AfricanDaniel/metal-quadruped/dog_imu/README.md

# dog_imu

ROS 2 driver node for the LSM6DSO32 6-axis IMU, mounted on the Jetson and
read over I2C. Publishes `sensor_msgs/msg/Imu`.

Promoted from the `actuator/src/imu_reader.py` prototype (same
register-level driver logic, WHO_AM_I check included), but wired up as a
real publisher instead of printing to the console — this is what
`dog_deploy` subscribes to for the IMU half of a policy's observation, and
what `dog_gym`'s simulated `accelerometer`/`gyro` sensors are meant to
match the shape of.

```
dog_imu/
├── package.xml
├── setup.py / setup.cfg
├── resource/dog_imu
├── config/
│   └── imu_calibration.yaml   # generated by calibrate_imu, read by imu_node
├── data/imu_calibration/       # raw CSVs from each calibrate_imu run
└── dog_imu/
    ├── imu_node.py
    └── calibrate_imu_node.py
```

## Node: `imu_node`

On startup: opens the I2C bus, reads `WHO_AM_I` (logged for a sanity
check), configures the accelerometer (104 Hz, ±4g) and gyroscope (104 Hz,
500 dps), then publishes `sensor_msgs/Imu` on `imu/data_raw` on a timer.

- `angular_velocity` — rad/s (converted from the sensor's deg/s).
- `linear_acceleration` — m/s².
- `orientation` — left as identity with `orientation_covariance[0] = -1`,
  the `sensor_msgs/Imu` convention for "no orientation estimate available"
  (this sensor has no onboard sensor fusion — it's raw accel + gyro only).

Also publishes `imu/data` — the same readings rotated into a forward/left/up
(ROS REP-103) body frame, using `config/imu_calibration.yaml` — but only
once that file has actually been produced by `calibrate_imu` (see below).
Before that, only the raw `imu/data_raw` is published (a warning is logged
once at startup saying so).

**Why two topics**: the raw sensor's X/Y/Z axes are whatever direction the
physical board happens to be glued down in — there's no way to know which
one is "forward" without physically testing it (see `calibrate_imu`
below). `imu/data_raw` is always the sensor's own raw axes, unaffected by
calibration; `imu/data` is what `dog_deploy` and anything else that cares
about "forward/left/up" should actually subscribe to.

### Parameters

| Name | Type | Default | Description |
|---|---|---|---|
| `bus_id` | int | `7` | I2C bus number (Jetson Orin Nano: bus 7) |
| `i2c_addr` | int | `0x6A` | LSM6DSO32 I2C address |
| `frame_id` | string | `imu_link` | Frame ID stamped on published messages |
| `publish_rate_hz` | double | `1.0` | Publish rate (independent of the sensor's own ODR) |
| `calibration_path`  | string | `<share>/dog_imu/config/imu_calibration.yaml` | Where to look for the calibration file  |

## Node: `calibrate_imu`

Guided, physical calibration of the IMU's mounting orientation — walks
you through tilting the robot in 4 directions (nose down, nose up, left,
right, in that order) while `imu_node` is running, records the raw
readings, and figures out which raw axis is forward/left/up (and whether
each needs to be sign-flipped) purely from how the sensor actually
responded to being tilted. Writes:

- A timestamped raw-sample CSV to `data/imu_calibration/`.
- `config/imu_calibration.yaml`, picked up by `imu_node` on its next
  start (restart `imu_node` after calibrating).

**Re-run this any time the IMU gets unplugged, remounted, or otherwise
might have moved** — the calibration is a physical-mounting fact, not
something that can be assumed to stay valid. It's a ~30 second guided
procedure, not a one-time setup step.

```bash
# terminal 1
ros2 run dog_imu imu_node

# terminal 2 -- follow the on-screen prompts
ros2 run dog_imu calibrate_imu
```

To make a calibration persist across future `colcon build`s: a plain
(non-symlink) install only copies `config/imu_calibration.yaml` from the
*source* tree at build time, so copy the freshly-generated file over
`src/dog_imu/config/imu_calibration.yaml` once you're happy with it (and
commit it, same as `actuator/config/preset_pose.yaml`) — otherwise the
next rebuild reverts to whatever's currently checked in. The checked-in
file currently holds real calibration data from the robot (`calibrated:
true`, an identity axis mapping — no flips/rotation needed for this
mounting).

## Usage

```bash
colcon build --packages-select dog_imu
source install/setup.bash
ros2 run dog_imu imu_node
```

```bash
ros2 topic echo /imu/data_raw   # raw sensor axes, always available
ros2 topic echo /imu/data       # forward/left/up, only after calibrate_imu has run
```

Requires hardware (the LSM6DSO32 over I2C) — there's no simulated fallback
here, so this can only be run/verified on the Jetson, not the dev machine.

## Register map reference

Carried over from the original prototype:

- `0x0F` `WHO_AM_I` — read-only ID check.
- `0x10` `CTRL1_XL` — accelerometer ODR + full-scale. `0x58` = 104 Hz, ±4g.
- `0x11` `CTRL2_G` — gyroscope ODR + full-scale. `0x54` = 104 Hz, 500 dps.
- `0x22`-`0x27` — gyro X/Y/Z, 16-bit signed, low byte first.
- `0x28`-`0x2D` — accel X/Y/Z, 16-bit signed, low byte first.

Sensitivity for the settings above: gyro `0.0175 dps/LSB`, accel
`0.000122 g/LSB`.
