AfricanDaniel/metal-quadruped/dog_description/onshape_folders/robot_dog/assets/thigh_connecor_full.stl

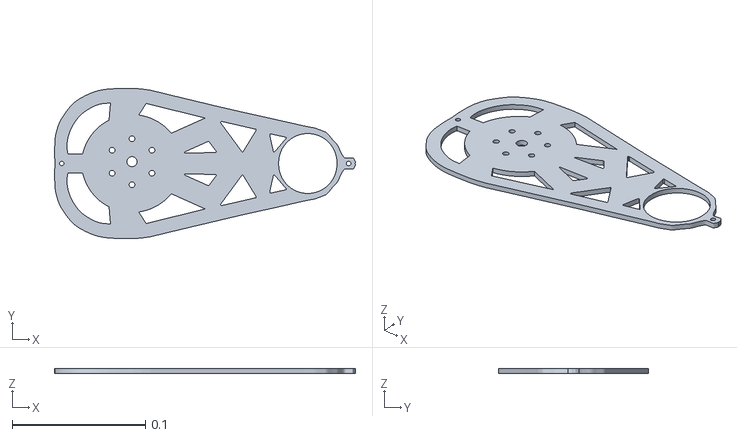
[picture p1: CAD file, 2026-07-23]
dog_description/onshape_folders/robot_dog/assets/thigh_connecor_full.stl
0.226 x 0.113 x 0.0035
