AfricanDaniel/metal-quadruped/dog_description/onshape_folders/robot_dog/assets/feet_connector.stl

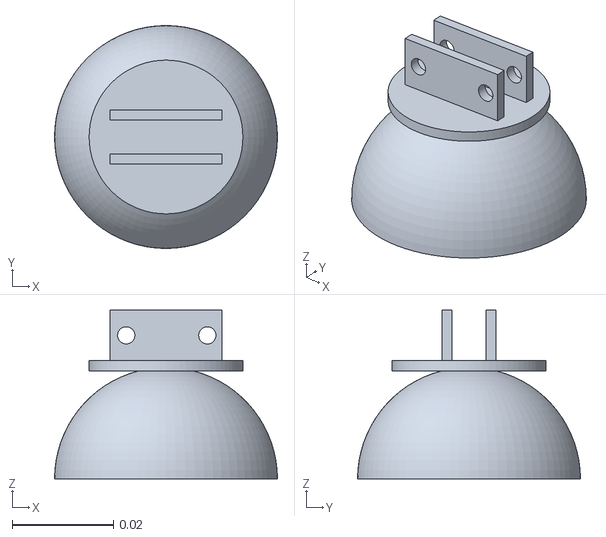
[picture p2: CAD file, 2026-07-23]
dog_description/onshape_folders/robot_dog/assets/feet_connector.stl
0.044 x 0.044 x 0.0333
