AfricanDaniel/metal-quadruped/dog_description/onshape_folders/urdf_dog/full_dog/meshes/motor_casing.stl

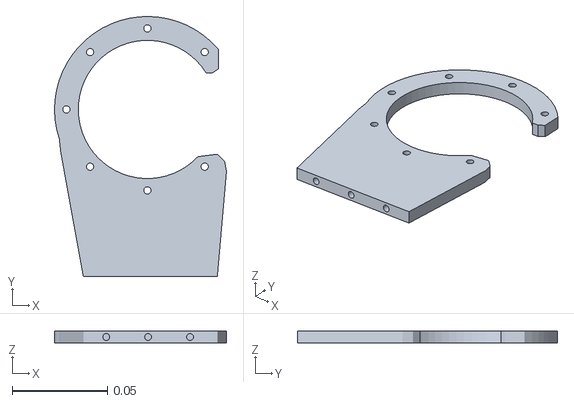
[picture p3: CAD file, 2026-07-23]
dog_description/onshape_folders/urdf_dog/full_dog/meshes/motor_casing.stl
0.0902 x 0.136 x 0.0065
