AfricanDaniel/metal-quadruped/dog_description/onshape_folders/robot_dog/assets/timing_belt_pulley_lower_shaft.stl

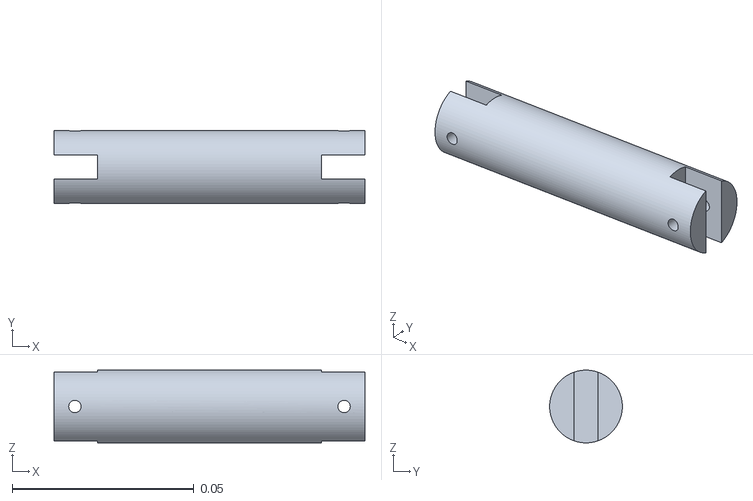
[picture p4: CAD file, 2026-07-23]
dog_description/onshape_folders/robot_dog/assets/timing_belt_pulley_lower_shaft.stl
0.0855 x 0.02 x 0.02
