AfricanDaniel/metal-quadruped/dog_description/onshape_folders/urdf_dog/full_dog/meshes/shoulder.stl

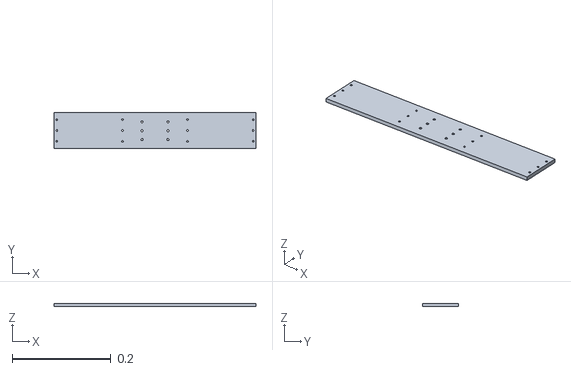
[picture p5: CAD file, 2026-07-23]
dog_description/onshape_folders/urdf_dog/full_dog/meshes/shoulder.stl
0.41 x 0.073 x 0.0065
