AfricanDaniel/metal-quadruped/dog_description/onshape_folders/robot_dog/assets/timing_belt_pulley_lower.stl

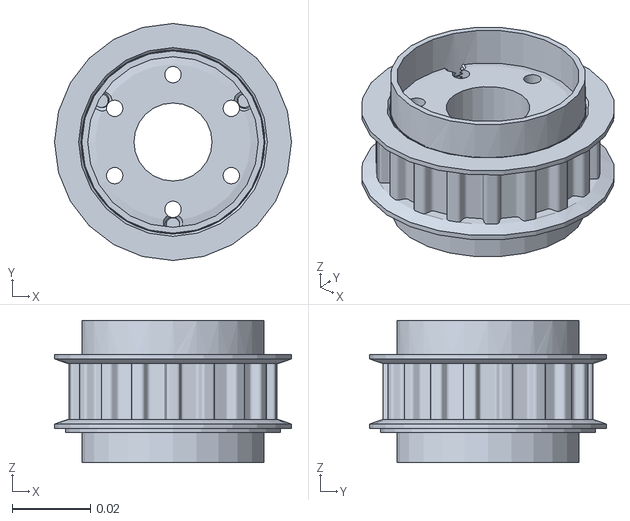
[picture p6: CAD file, 2026-07-23]
dog_description/onshape_folders/robot_dog/assets/timing_belt_pulley_lower.stl
0.0607 x 0.0607 x 0.0365
