AfricanDaniel/metal-quadruped/dog_description/onshape_folders/robot_dog/assets/motor_casing_spacers.stl

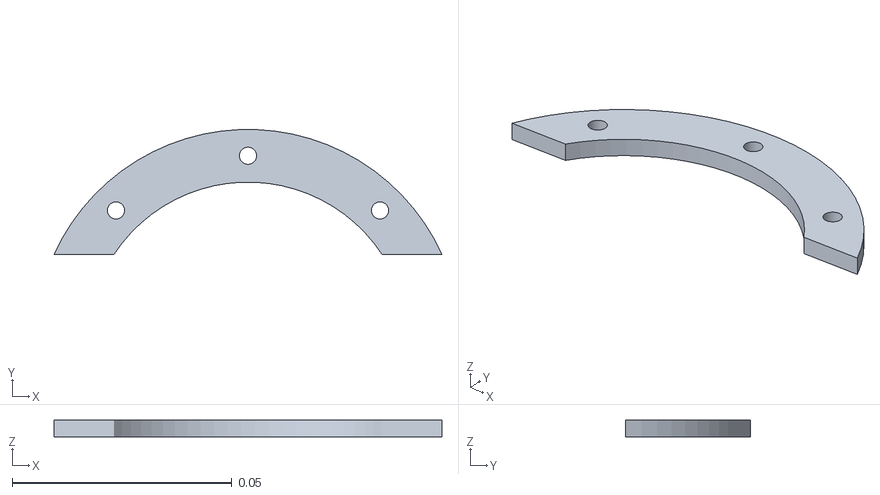
[picture p7: CAD file, 2026-07-23]
dog_description/onshape_folders/robot_dog/assets/motor_casing_spacers.stl
0.0883 x 0.0284 x 0.0038
