AfricanDaniel/metal-quadruped/dog_description/onshape_folders/robot_dog/assets/lower_shaft_connector_to_feet.stl

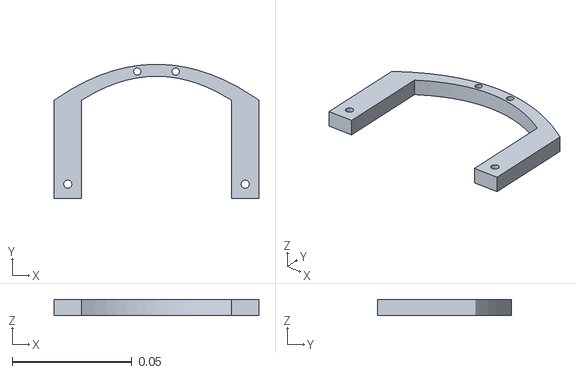
[picture p8: CAD file, 2026-07-23]
dog_description/onshape_folders/robot_dog/assets/lower_shaft_connector_to_feet.stl
0.0855 x 0.056 x 0.0067
