AfricanDaniel/metal-quadruped/dog_description/onshape_folders/urdf_dog/full_dog/meshes/battery.stl

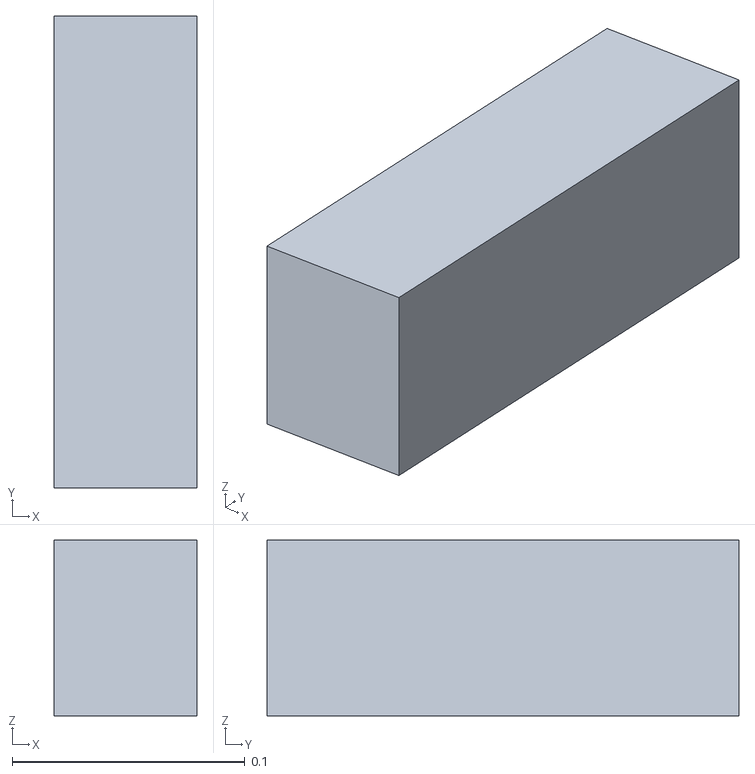
[picture p9: CAD file, 2026-07-23]
dog_description/onshape_folders/urdf_dog/full_dog/meshes/battery.stl
0.0615 x 0.203 x 0.0755
