AfricanDaniel/metal-quadruped/dog_description/onshape_folders/robot_dog/assets/motor.stl

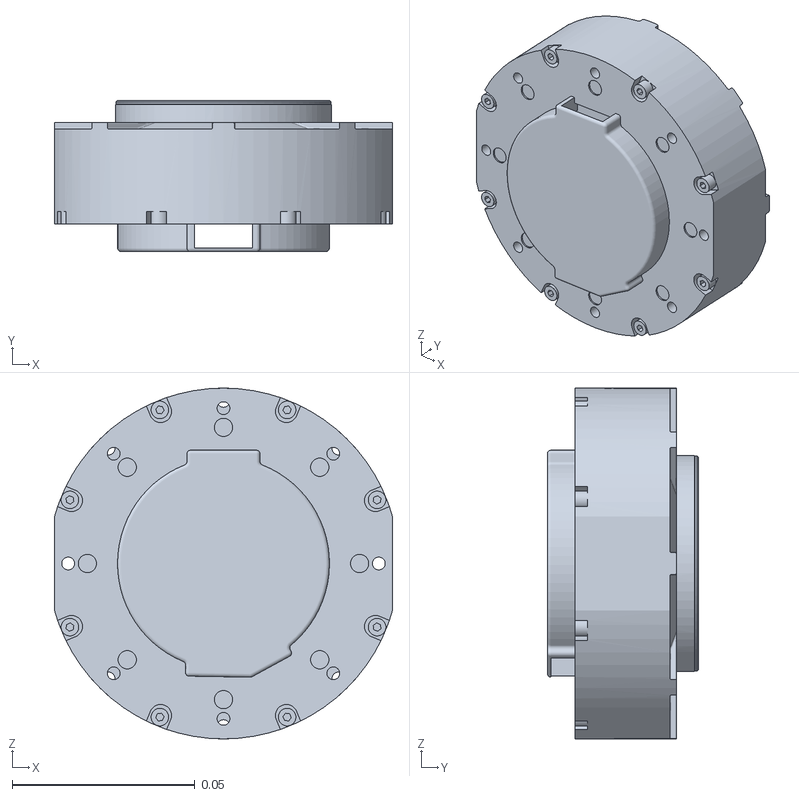
[picture p10: CAD file, 2026-07-23]
dog_description/onshape_folders/robot_dog/assets/motor.stl
0.0925 x 0.0414 x 0.096
