AfricanDaniel/metal-quadruped/dog_description/onshape_folders/urdf_dog/full_dog/meshes/ball_for_feet.stl

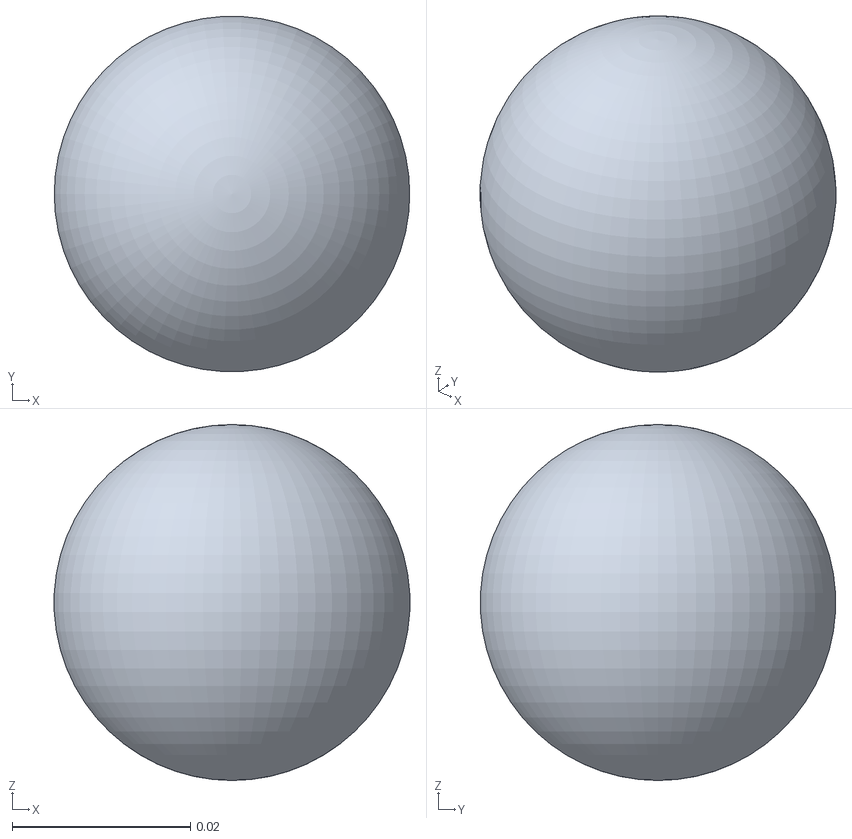
[picture p11: CAD file, 2026-07-23]
dog_description/onshape_folders/urdf_dog/full_dog/meshes/ball_for_feet.stl
0.0399 x 0.0399 x 0.04
