AfricanDaniel/metal-quadruped/dog_description/onshape_folders/urdf_dog/full_dog/meshes/timing_belt_pulley_upper.stl

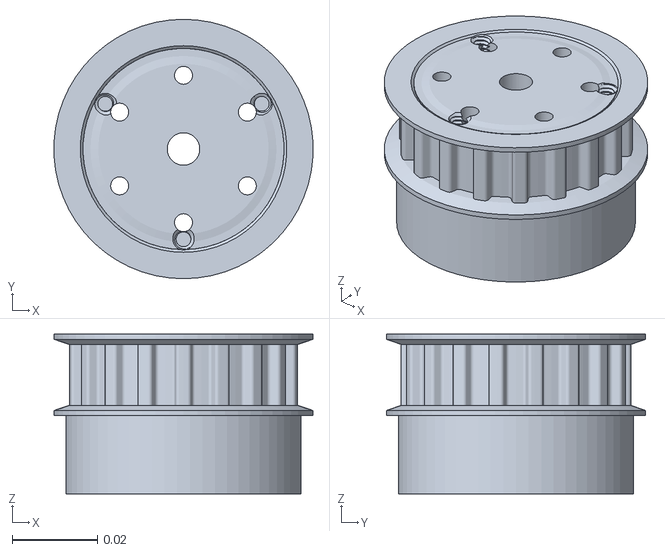
[picture p12: CAD file, 2026-07-23]
dog_description/onshape_folders/urdf_dog/full_dog/meshes/timing_belt_pulley_upper.stl
0.0606 x 0.0607 x 0.0373
