AfricanDaniel/metal-quadruped/dog_description/onshape_folders/robot_dog/assets/spacer_between_thigh_connector.stl

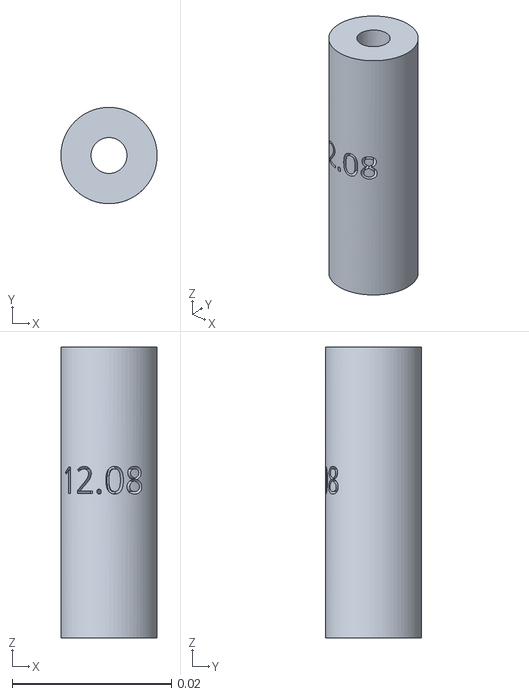
[picture p13: CAD file, 2026-07-23]
dog_description/onshape_folders/robot_dog/assets/spacer_between_thigh_connector.stl
0.0121 x 0.0121 x 0.0365
