AfricanDaniel/metal-quadruped/dog_description/onshape_folders/urdf_dog/full_dog/meshes/torso.stl

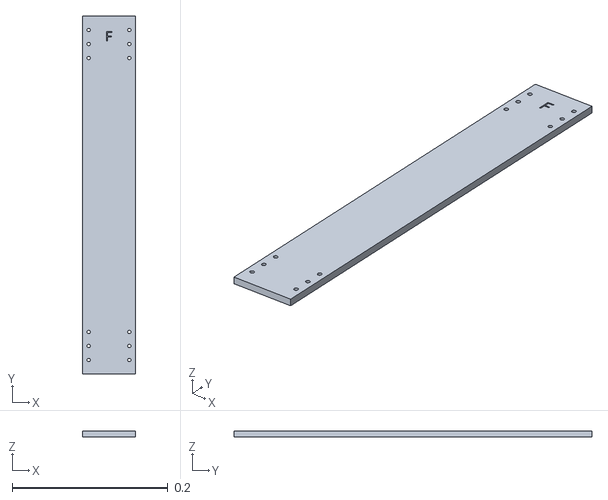
[picture p14: CAD file, 2026-07-23]
dog_description/onshape_folders/urdf_dog/full_dog/meshes/torso.stl
0.0675 x 0.46 x 0.0072
