AfricanDaniel/metal-quadruped/dog_description/onshape_folders/urdf_dog/full_dog/meshes/thigh_connector_hollow.stl

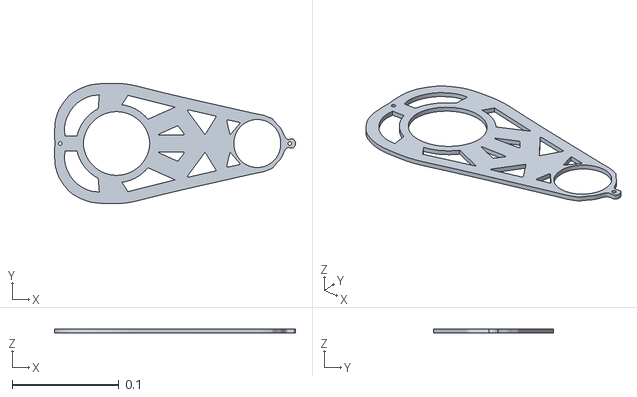
[picture p15: CAD file, 2026-07-23]
dog_description/onshape_folders/urdf_dog/full_dog/meshes/thigh_connector_hollow.stl
0.226 x 0.113 x 0.0035
