AfricanDaniel/metal-quadruped/dog_description/onshape_folders/urdf_dog/full_dog/meshes/Part_B_1__Body1.stl

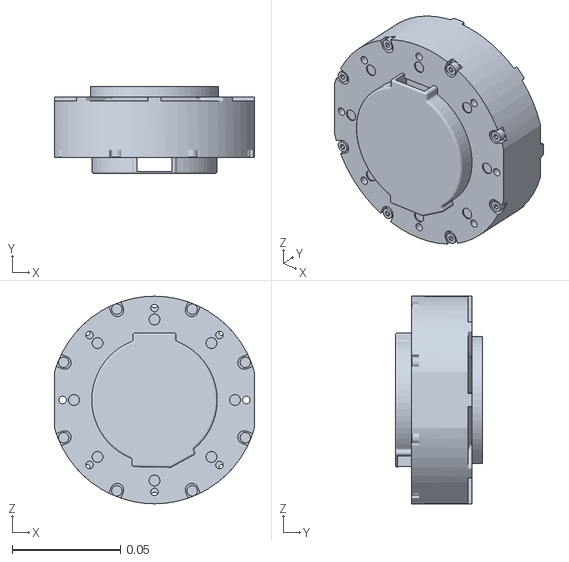
[picture p16: CAD file, 2026-07-23]
dog_description/onshape_folders/urdf_dog/full_dog/meshes/Part_B_1__Body1.stl
0.0925 x 0.0403 x 0.096
