AfricanDaniel/metal-quadruped/dog_description/onshape_folders/robot_dog/assets/imu.stl

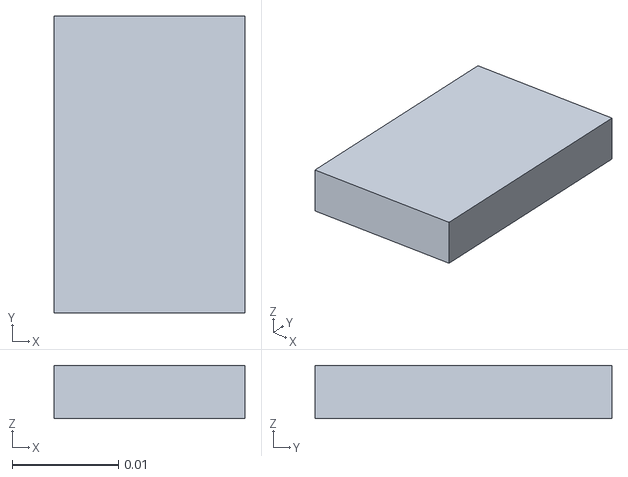
[picture p17: CAD file, 2026-07-23]
dog_description/onshape_folders/robot_dog/assets/imu.stl
0.018 x 0.028 x 0.005
