AfricanDaniel/metal-quadruped/dog_description/onshape_folders/urdf_dog/full_dog/meshes/Part_A_1__Body1.stl

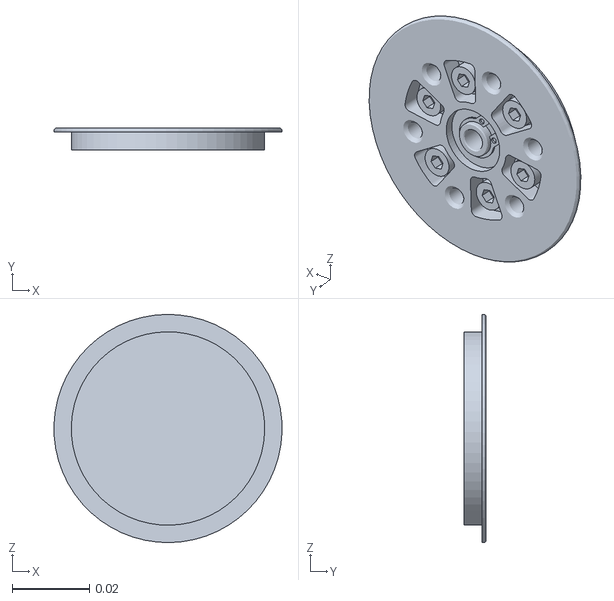
[picture p18: CAD file, 2026-07-23]
dog_description/onshape_folders/urdf_dog/full_dog/meshes/Part_A_1__Body1.stl
0.059 x 0.0057 x 0.059
