AfricanDaniel/metal-quadruped/(list of files, cad)

Other CAD files:
dog_description/onshape_folders/urdf_dog/full_dog/meshes/thigh_connecor_full.stl
dog_description/onshape_folders/urdf_dog/full_dog/meshes/timing_belt_pulley_lower.stl
dog_description/onshape_folders/urdf_dog/full_dog/meshes/timing_belt_pulley_lower_shaft.stl
dog_description/onshape_folders/urdf_dog/full_dog/meshes/lower_shaft_connector_to_feet.stl
dog_description/onshape_folders/robot_dog/assets/shoulder.stl
dog_description/onshape_folders/robot_dog/assets/motor_casing.stl
dog_description/onshape_folders/robot_dog/assets/ball_for_feet.stl
dog_description/onshape_folders/urdf_dog/full_dog/meshes/feet_connector.stl
dog_description/onshape_folders/robot_dog/assets/torso.stl
dog_description/onshape_folders/robot_dog/assets/thigh_connector_hollow.stl
dog_description/onshape_folders/urdf_dog/full_dog/meshes/spacer_between_thigh_connector.stl
dog_description/onshape_folders/robot_dog/assets/timing_belt_pulley_upper.stl
dog_description/onshape_folders/robot_dog/assets/battery.stl
dog_description/onshape_folders/urdf_dog/full_dog/meshes/IMU.stl
dog_description/onshape_folders/urdf_dog/full_dog/meshes/motor_casing_spacers.stl
