AfricanDaniel/metal-quadruped/dog_description/onshape_folders/urdf_dog/full_dog/urdf/full_dog.urdf

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
<robot name="full_dog">
    <link name="ball_for_feet">
        <inertial>
            <mass value="0.0368614" />
            <origin xyz="4.59243e-19 0 -3.46945e-18" rpy="0 -0 0" />
            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
        </inertial>
        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
    </link>
    <link name="ball_for_feet_1">
        <inertial>
            <mass value="0.0368614" />
            <origin xyz="4.59243e-19 0 -3.46945e-18" rpy="0 -0 0" />
            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
        </inertial>
        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
    </link>
    <link name="ball_for_feet_2">
        <inertial>
            <mass value="0.0368614" />
            <origin xyz="4.59243e-19 0 -3.46945e-18" rpy="0 -0 0" />
            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
        </inertial>
        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
    </link>
    <link name="ball_for_feet_3">
        <inertial>
            <mass value="0.0368614" />
            <origin xyz="4.59243e-19 0 -3.46945e-18" rpy="0 -0 0" />
            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
        </inertial>
        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
    </link>
    <link name="battery">
        <inertial>
            <mass value="1.17822" />
            <origin xyz="-0.03075 -2.47868e-17 -6.93889e-18" rpy="0 -0 0" />
            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
        </inertial>
        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
    </link>
    <link name="feet_connector">
        <inertial>
            <mass value="0.00970941" />
            <origin xyz="-0.0081562 -0.00335 -0.0138107" rpy="0 -0 0" />
            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
        </inertial>
        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
    </link>
    <link name="feet_connector_1">
        <inertial>
            <mass value="0.00970941" />
            <origin xyz="-0.0081562 -0.00335 -0.0138107" rpy="0 -0 0" />
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
        </inertial>
        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
    </link>
    <link name="timing_belt_pulley_lower_shaft">
        <inertial>
            <mass value="0.0633572" />
            <origin xyz="3.56914e-18 -1.42421e-13 9.15845e-14" rpy="0 -0 0" />
            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
        </inertial>
        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
    </link>
    <link name="timing_belt_pulley_lower_shaft_1">
        <inertial>
            <mass value="0.0633572" />
            <origin xyz="3.56914e-18 -1.42421e-13 9.15845e-14" rpy="0 -0 0" />
            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
        </inertial>
        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
    </link>
    <link name="timing_belt_pulley_lower_shaft_2">
        <inertial>
            <mass value="0.0633572" />
            <origin xyz="3.56914e-18 -1.42421e-13 9.15845e-14" rpy="0 -0 0" />
            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
        </inertial>
        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
    </link>
    <link name="timing_belt_pulley_lower_shaft_3">
        <inertial>
            <mass value="0.0633572" />
            <origin xyz="3.56914e-18 -1.42421e-13 9.15845e-14" rpy="0 -0 0" />
            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
        </inertial>
        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
    </link>
    <link name="timing_belt_pulley_upper">
        <inertial>
            <mass value="0.0998201" />
            <origin xyz="7.78619e-09 4.72925e-09 0.0181907" rpy="0 -0 0" />
            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
        </inertial>
        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
    </link>
    <link name="timing_belt_pulley_upper_1">
        <inertial>
            <mass value="0.0998201" />
            <origin xyz="7.78619e-09 4.72925e-09 0.0181907" rpy="0 -0 0" />
            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
        </inertial>
        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
    </link>
    <link name="timing_belt_pulley_upper_2">
        <inertial>
            <mass value="0.0998201" />
            <origin xyz="7.78619e-09 4.72925e-09 0.0181907" rpy="0 -0 0" />
            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
        </inertial>
        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
    </link>
    <link name="timing_belt_pulley_upper_3">
        <inertial>
            <mass value="0.0998201" />
            <origin xyz="7.78619e-09 4.72925e-09 0.0181907" rpy="0 -0 0" />
            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
        </inertial>
        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
    </link>
    <link name="torso">
        <inertial>
            <mass value="0.599638" />
            <origin xyz="4.79264e-07 -9.0235e-05 0.00359908" rpy="0 -0 0" />
            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
        </inertial>
        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
    </link>
    <joint name="_bll__fastened_feet_connector_and_rubber_ball" type="fixed">
        <origin xyz="-0.00815475 -0.00335 -0.028333" rpy="2.13916e-61 1.57772e-30 2.71171e-31" />
        <axis xyz="0 0 1" />
        <parent link="feet_connector_3" />
        <child link="ball_for_feet" />
    </joint>
    <joint name="_bll__fastened_horseshoe_and_feet_conector" type="fixed">
        <origin xyz="0.045 0.0469611 -1.38778e-17" rpy="1.5708 -1.52842e-30 -3.45127e-31" />
        <axis xyz="0 -1 0" />
        <parent link="lower_shaft_connector_to_feet_1" />
        <child link="feet_connector_3" />
    </joint>
    <joint name="_bll__fastened_motor_7_and_lower_spacer" type="fixed">
        <origin xyz="0.085 0 2.77556e-17" rpy="0 -1.5708 -1.5708" />
        <axis xyz="0 0 1" />
        <parent link="part_a_1__body1_4" />
        <child link="motor_casing_spacers_14" />
    </joint>
    <joint name="_bll__fastened_motor_7_and_timing_belt_upper" type="fixed">
        <origin xyz="0.0425 0.0339 8.32667e-17" rpy="-1.5708 -5.9559e-29 6.07873e-15" />
        <axis xyz="0 0 -1" />
        <parent link="part_a_1__body1_4" />
        <child link="timing_belt_pulley_upper_2" />
    </joint>
    <joint name="_bll__fastened_motor_7_and_upper_spacer" type="fixed">
        <origin xyz="-2.77556e-17 2.77556e-17 0.0038" rpy="1.5708 -0 -1.5708" />
        <axis xyz="-0 -1 -0" />
        <parent link="motor_casing_spacers_7" />
        <child link="part_a_1__body1_4" />
    </joint>
    <joint name="_bll__fastened_motor_7_casing_and_spacers" type="fixed">
        <origin xyz="-0.0223731 0.0451405 0.00325" rpy="1.46406e-61 1.47911e-31 -3.14159" />
        <axis xyz="0 0 -1" />
        <parent link="motor_casing_4" />
        <child link="motor_casing_spacers_7" />
    </joint>
    <joint name="_bll__fastened_motor_8_and_lower_spacer" type="fixed">
        <origin xyz="-0.085 -2.77556e-17 2.77556e-17" rpy="0 1.5708 1.5708" />
        <axis xyz="0 0 1" />
        <parent link="part_a_1__body1_1" />
        <child link="motor_casing_spacers_5" />
    </joint>
    <joint name="_bll__fastened_motor_8_and_upper_spacer" type="fixed">
        <origin xyz="2.77556e-17 2.77556e-17 0.0038" rpy="1.5708 -0 1.5708" />
        <axis xyz="-0 -1 -0" />
        <parent link="motor_casing_spacers_8" />
        <child link="part_a_1__body1_1" />
    </joint>
    <joint name="_bll__fastened_motor_8_casing_and_spacers" type="fixed">
        <origin xyz="-0.0223731 0.0451405 -0.00325" rpy="3.14159 -7.1325e-43 1.17327e-28" />
        <axis xyz="0 0 -1" />
        <parent link="motor_casing_3" />
        <child link="motor_casing_spacers_8" />
    </joint>
    <joint name="_bll__fastened_screw_spacer_and_full_thigh" type="fixed">
        <origin xyz="-0.0501423 -0.0163467 0.0035" rpy="3.14159 2.78234e-30 -1.28134" />
        <axis xyz="0 0 1" />
        <parent link="thigh_connecor_full_2" />
        <child link="spacer_between_thigh_connector_2" />
    </joint>
    <joint name="_bll__fastened_screw_spacer_and_hollow_thigh" type="fixed">
        <origin xyz="4.85723e-17 0 -0.0365" rpy="-3.14159 -1.30162e-29 -1.5708" />
        <axis xyz="-0 -0 -1" />
        <parent link="spacer_between_thigh_connector_2" />
        <child link="thigh_connector_hollow_3" />
    </joint>
    <joint name="_bll__fastened_shaft_and_horseshoe" type="fixed">
        <origin xyz="-0.037 -0.00335 0" rpy="1.5708 -2.36658e-30 -5.2262e-30" />
        <axis xyz="0 0 1" />
        <parent link="timing_belt_pulley_lower_shaft_2" />
        <child link="lower_shaft_connector_to_feet_1" />
    </joint>
    <joint name="_bll__fastened_shoulder_and_motor_7_casing" type="fixed">
        <origin xyz="-0.0922 0.0045 -0.0065" rpy="-1.5708 -0 1.5708" />
        <axis xyz="0 -1 0" />
        <parent link="shoulder" />
        <child link="motor_casing_4" />
    </joint>
    <joint name="_bll__fastened_shoulder_and_motor_8_casing" type="fixed">
        <origin xyz="-0.22545 0.0045 -0.0065" rpy="-1.5708 -0 1.5708" />
        <axis xyz="0 -1 0" />
        <parent link="shoulder" />
        <child link="motor_casing_3" />
    </joint>
    <joint name="_bll__fastened_timing_belt_shaft_and_lower_pulley" type="fixed">
        <origin xyz="2.31482e-14 7.96585e-15 0.01775" rpy="0 -1.5708 3.47241" />
        <axis xyz="-1 -0 -0" />
        <parent link="timing_belt_pulley_lower_3" />
        <child link="timing_belt_pulley_lower_shaft_2" />
    </joint>
    <joint name="_bll__revolute_motor_8_and_thigh" type="continuous">
        <origin xyz="-0.0425 0.0337 8.32667e-17" rpy="0 -1.5708 -1.5708" />
        <axis xyz="0 0 -1" />
        <parent link="part_a_1__body1_1" />
        <child link="thigh_connecor_full_2" />
    </joint>
    <joint name="_bll__revolute_thigh_and_lower_pulley" type="continuous">
        <origin xyz="0.184559 0.000619719 0" rpy="-3.14159 9.04594e-21 -1.5708" />
        <axis xyz="0 0 -1" />
        <parent link="thigh_connector_hollow_3" />
        <child link="timing_belt_pulley_lower_3" />
    </joint>
    <joint name="_brl__fastened_feet_connector_and_rubber_ball" type="fixed">
        <origin xyz="-0.00815475 -0.00335 -0.028333" rpy="0 -0 7.39557e-31" />
        <axis xyz="0 0 1" />
        <parent link="feet_connector_2" />
        <child link="ball_for_feet_1" />
    </joint>
    <joint name="_brl__fastened_horseshoe_and_feet_conector" type="fixed">
        <origin xyz="0.045 0.0469611 -1.38778e-17" rpy="1.5708 -7.39557e-31 1.97215e-31" />
        <axis xyz="0 -1 0" />
        <parent link="lower_shaft_connector_to_feet" />
        <child link="feet_connector_2" />
    </joint>
    <joint name="_brl__fastened_motor_5_and_lower_spacer" type="fixed">
        <origin xyz="0.085 -2.77556e-17 0" rpy="0 -1.5708 4.71239" />
        <axis xyz="0 0 1" />
        <parent link="part_a_1__body1_2" />
        <child link="motor_casing_spacers_13" />
    </joint>
    <joint name="_brl__fastened_motor_5_and_upper_spacer" type="fixed">
        <origin xyz="0 -8.32667e-17 0.0038" rpy="1.5708 -0 -1.5708" />
        <axis xyz="-0 -1 -0" />
        <parent link="motor_casing_spacers_4" />
        <child link="part_a_1__body1_2" />
    </joint>
    <joint name="_brl__fastened_motor_6_and_lower_spacer" type="fixed">
        <origin xyz="-0.0223731 0.130141 -0.00325" rpy="8.39038e-19 -1.62257e-17 -2.22045e-16" />
        <axis xyz="0 0 1" />
        <parent link="motor_casing" />
        <child link="motor_casing_spacers_12" />
    </joint>
    <joint name="_brl__fastened_motor_6_and_timing_belt_upper" type="fixed">
        <origin xyz="-0.0425 0.0339 1.38778e-16" rpy="-1.5708 -1.44255e-16 6.22299e-15" />
        <axis xyz="0 0 -1" />
        <parent link="part_a_1__body1" />
        <child link="timing_belt_pulley_upper_3" />
    </joint>
    <joint name="_brl__fastened_motor_6_and_upper_spacer" type="fixed">
        <origin xyz="1.11022e-16 1.31839e-16 -0.0038" rpy="-1.5708 -0 1.5708" />
        <axis xyz="0 -1 0" />
        <parent link="motor_casing_spacers_3" />
        <child link="part_a_1__body1" />
    </joint>
    <joint name="_brl__fastened_motor_6_casing_and_spacers" type="fixed">
        <origin xyz="-0.0223731 0.0451405 -0.00325" rpy="-1.37472e-16 4.00989e-18 3.14159" />
        <axis xyz="0 0 1" />
        <parent link="motor_casing" />
        <child link="motor_casing_spacers_3" />
    </joint>
    <joint name="_brl__fastened_screw_spacer_and_full_thigh" type="fixed">
        <origin xyz="-0.0501147 -0.0164309 -0.0035" rpy="-3.14159 1.29112e-18 -1.27966" />
        <axis xyz="0 0 -1" />
        <parent link="thigh_connecor_full" />
        <child link="spacer_between_thigh_connector" />
    </joint>
    <joint name="_brl__fastened_screw_spacer_and_hollow_thigh" type="fixed">
        <origin xyz="-1.21431e-15 6.10623e-16 0.0365" rpy="3.14159 -1.73472e-18 -1.5708" />
        <axis xyz="-0 -0 1" />
        <parent link="spacer_between_thigh_connector" />
        <child link="thigh_connector_hollow_1" />
    </joint>
    <joint name="_brl__fastened_shaft_and_horseshoe" type="fixed">
        <origin xyz="-0.037 -0.00335 1.38778e-17" rpy="1.5708 6.93889e-18 -6.93889e-18" />
        <axis xyz="0 0 1" />
        <parent link="timing_belt_pulley_lower_shaft_3" />
        <child link="lower_shaft_connector_to_feet" />
    </joint>
    <joint name="_brl__fastened_shoulder_and_motor_5_casing" type="fixed">
        <origin xyz="0.17295 0.0045 -0.0065" rpy="-1.5708 -5.55112e-17 1.5708" />
        <axis xyz="0 -1 0" />
        <parent link="shoulder" />
        <child link="motor_casing_5" />
    </joint>
    <joint name="_brl__fastened_shoulder_and_motor_6_casing" type="fixed">
        <origin xyz="0.0397 0.0045 -0.0065" rpy="-1.5708 -5.55112e-17 1.5708" />
        <axis xyz="0 -1 0" />
        <parent link="shoulder" />
        <child link="motor_casing" />
    </joint>
    <joint name="_brl__fastened_timing_belt_shaft_and_lower_pulley" type="fixed">
        <origin xyz="-2.31135e-14 -8.14626e-15 0.01775" rpy="0 -1.5708 0.338865" />
        <axis xyz="-1 -0 -0" />
        <parent link="timing_belt_pulley_lower" />
        <child link="timing_belt_pulley_lower_shaft_3" />
    </joint>
    <joint name="_brl__revolute_motor_5_and_thigh" type="continuous">
        <origin xyz="0.0425 0.0339 -5.55112e-17" rpy="0 -1.5708 1.5708" />
        <axis xyz="0 0 1" />
        <parent link="part_a_1__body1_2" />
        <child link="thigh_connecor_full" />
    </joint>
    <joint name="_brl__revolute_thigh_and_lower_pulley" type="continuous">
        <origin xyz="0.126856 0.0359509 -0.0035" rpy="3.14159 -7.23646e-17 1.86193" />
        <axis xyz="0 0 -1" />
        <parent link="thigh_connecor_full" />
        <child link="timing_belt_pulley_lower" />
    </joint>
    <joint name="_fll__fastened_feet_connector_and_rubber_ball" type="fixed">
        <origin xyz="-0.00815475 -0.00335 -0.028333" rpy="-2.67395e-61 -7.88861e-31 6.77927e-31" />
        <axis xyz="0 0 1" />
        <parent link="feet_connector_1" />
        <child link="ball_for_feet_2" />
    </joint>
    <joint name="_fll__fastened_horseshoe_and_feet_conector" type="fixed">
        <origin xyz="0.045 0.0469611 5.55112e-17" rpy="1.5708 -1.33367e-29 2.29263e-30" />
        <axis xyz="0 -1 0" />
        <parent link="lower_shaft_connector_to_feet_2" />
        <child link="feet_connector_1" />
    </joint>
    <joint name="_fll__fastened_motor_3_and_lower_spacer" type="fixed">
        <origin xyz="0.0216269 0.130141 -0.00325" rpy="1.2326e-31 3.32808e-45 2.05109e-76" />
        <axis xyz="0 0 1" />
        <parent link="motor_casing_6" />
        <child link="motor_casing_spacers_9" />
    </joint>
    <joint name="_fll__fastened_motor_3_and_timing_belt_upper" type="fixed">
        <origin xyz="-0.0425 0.0339 5.55112e-17" rpy="-1.5708 -2.22045e-16 6.07873e-15" />
        <axis xyz="0 0 -1" />
        <parent link="part_a_1__body1_3" />
        <child link="timing_belt_pulley_upper" />
    </joint>
    <joint name="_fll__fastened_motor_3_and_upper_spacer" type="fixed">
        <origin xyz="-2.77556e-17 1.38778e-17 -0.0038" rpy="-1.5708 -0 1.5708" />
        <axis xyz="0 -1 0" />
        <parent link="motor_casing_spacers_15" />
        <child link="part_a_1__body1_3" />
    </joint>
    <joint name="_fll__fastened_motor_3_casing_and_spacers" type="fixed">
        <origin xyz="0.0216269 0.0451405 -0.00325" rpy="8.62817e-32 -4.93038e-32 3.14159" />
        <axis xyz="0 0 1" />
        <parent link="motor_casing_6" />
        <child link="motor_casing_spacers_15" />
    </joint>
    <joint name="_fll__fastened_motor_4_and_lower_spacer" type="fixed">
        <origin xyz="0.085 0 2.77556e-17" rpy="0 -1.5708 4.71239" />
        <axis xyz="0 0 1" />
        <parent link="part_a_1__body1_5" />
        <child link="motor_casing_spacers_1" />
    </joint>
    <joint name="_fll__fastened_motor_4_and_upper_spacer" type="fixed">
        <origin xyz="2.77556e-17 -4.09395e-16 0.0038" rpy="1.5708 -0 -1.5708" />
        <axis xyz="-0 -1 -0" />
        <parent link="motor_casing_spacers_2" />
        <child link="part_a_1__body1_5" />
    </joint>
    <joint name="_fll__fastened_motor_4_casing_and_spacers" type="fixed">
        <origin xyz="0.0216269 0.0451405 0.00325" rpy="1.1911e-44 -8.40779e-45 -3.14159" />
        <axis xyz="0 0 -1" />
        <parent link="motor_casing_7" />
        <child link="motor_casing_spacers_2" />
    </joint>
    <joint name="_fll__fastened_screw_spacer_and_full_thigh" type="fixed">
        <origin xyz="0.0507809 -0.0142396 -0.0035" rpy="3.14159 -1.09264e-29 1.27172" />
        <axis xyz="0 0 -1" />
        <parent link="thigh_connecor_full_3" />
        <child link="spacer_between_thigh_connector_1" />
    </joint>
    <joint name="_fll__fastened_screw_spacer_and_hollow_thigh" type="fixed">
        <origin xyz="6.93889e-16 7.77156e-16 0.0365" rpy="3.14159 -3.15544e-30 -1.5708" />
        <axis xyz="-0 -0 1" />
        <parent link="spacer_between_thigh_connector_1" />
        <child link="thigh_connector_hollow" />
    </joint>
    <joint name="_fll__fastened_shaft_and_horseshoe" type="fixed">
        <origin xyz="-0.037 -0.00335 5.55112e-17" rpy="1.5708 4.21548e-30 -3.9443e-30" />
        <axis xyz="0 0 1" />
        <parent link="timing_belt_pulley_lower_shaft_1" />
        <child link="lower_shaft_connector_to_feet_2" />
    </joint>
    <joint name="_fll__fastened_shoulder_and_motor_3_casing" type="fixed">
        <origin xyz="-0.0922 0.0045 -0.0065" rpy="-1.5708 -0 -1.5708" />
        <axis xyz="0 -1 0" />
        <parent link="shoulder_1" />
        <child link="motor_casing_6" />
    </joint>
    <joint name="_fll__fastened_shoulder_and_motor_4_casing" type="fixed">
        <origin xyz="-0.22545 0.0045 -0.0065" rpy="-1.5708 -0 -1.5708" />
        <axis xyz="-0 -1 -0" />
        <parent link="shoulder_1" />
        <child link="motor_casing_7" />
    </joint>
    <joint name="_fll__fastened_timing_belt_shaft_and_lower_pulley" type="fixed">
        <origin xyz="2.32592e-14 -7.54952e-15 0.01775" rpy="0 -1.5708 2.82118" />
        <axis xyz="-1 -0 -0" />
        <parent link="timing_belt_pulley_lower_1" />
        <child link="timing_belt_pulley_lower_shaft_1" />
    </joint>
    <joint name="_fll__revolute_motor_4_and_thigh" type="continuous">
        <origin xyz="0.0425 0.0339 5.55112e-17" rpy="0 -1.5708 1.5708" />
        <axis xyz="0 0 1" />
        <parent link="part_a_1__body1_5" />
        <child link="thigh_connecor_full_3" />
    </joint>
    <joint name="_fll__revolute_thigh_and_lower_pulley" type="continuous">
        <origin xyz="-0.125403 0.0407312 -0.0035" rpy="-3.14159 -3.32184e-24 -1.86988" />
        <axis xyz="0 0 -1" />
        <parent link="thigh_connecor_full_3" />
        <child link="timing_belt_pulley_lower_1" />
    </joint>
    <joint name="_frl__fastened_feet_connector_and_rubber_ball" type="fixed">
        <origin xyz="-0.00815475 -0.00335 -0.028333" rpy="9.60192e-61 1.97215e-30 9.7375e-31" />
        <axis xyz="0 0 1" />
        <parent link="feet_connector" />
        <child link="ball_for_feet_3" />
    </joint>
    <joint name="_frl__fastened_horseshoe_and_feet_conector" type="fixed">
        <origin xyz="0.045 0.0469611 -5.55112e-17" rpy="1.5708 -2.90892e-30 -4.19082e-31" />
        <axis xyz="0 -1 0" />
        <parent link="lower_shaft_connector_to_feet_3" />
        <child link="feet_connector" />
    </joint>
    <joint name="_frl__fastened_motor_1_and_lower_spacer" type="fixed">
        <origin xyz="-0.085 0 2.77556e-17" rpy="0 1.5708 1.5708" />
        <axis xyz="0 0 1" />
        <parent link="part_a_1__body1_6" />
        <child link="motor_casing_spacers_11" />
    </joint>
    <joint name="_frl__fastened_motor_1_and_upper_spacer" type="fixed">
        <origin xyz="0 0 0.0038" rpy="1.5708 -0 1.5708" />
        <axis xyz="-0 -1 -0" />
        <parent link="motor_casing_spacers" />
        <child link="part_a_1__body1_6" />
    </joint>
    <joint name="_frl__fastened_motor_1_casing_and_spacers" type="fixed">
        <origin xyz="0.0216269 0.0451405 -0.00325" rpy="3.14159 -3.28429e-47 -4.37906e-47" />
        <axis xyz="0 0 -1" />
        <parent link="motor_casing_1" />
        <child link="motor_casing_spacers" />
    </joint>
    <joint name="_frl__fastened_motor_2_and_lower_spacer" type="fixed">
        <origin xyz="0.085 0 2.77556e-17" rpy="0 -1.5708 4.71239" />
        <axis xyz="0 0 1" />
        <parent link="part_a_1__body1_7" />
        <child link="motor_casing_spacers_10" />
    </joint>
    <joint name="_frl__fastened_motor_2_and_timing_belt_upper" type="fixed">
        <origin xyz="0.0425 0.0339 8.32667e-17" rpy="-1.5708 -5.9559e-29 6.07873e-15" />
        <axis xyz="0 0 -1" />
        <parent link="part_a_1__body1_7" />
        <child link="timing_belt_pulley_upper_1" />
    </joint>
    <joint name="_frl__fastened_motor_2_and_upper_spacer" type="fixed">
        <origin xyz="0 -5.55112e-17 0.0038" rpy="1.5708 -0 -1.5708" />
        <axis xyz="-0 -1 -0" />
        <parent link="motor_casing_spacers_6" />
        <child link="part_a_1__body1_7" />
    </joint>
    <joint name="_frl__fastened_motor_2_casing_and_spacers" type="fixed">
        <origin xyz="0.0216269 0.0451405 0.00325" rpy="-2.18953e-47 3.42114e-47 3.14159" />
        <axis xyz="0 0 -1" />
        <parent link="motor_casing_2" />
        <child link="motor_casing_spacers_6" />
    </joint>
    <joint name="_frl__fastened_screw_spacer_and_full_thigh" type="fixed">
        <origin xyz="0.0508205 -0.0140973 0.0035" rpy="-3.14159 1.43828e-29 1.27452" />
        <axis xyz="0 0 1" />
        <parent link="thigh_connecor_full_1" />
        <child link="spacer_between_thigh_connector_3" />
    </joint>
    <joint name="_frl__fastened_screw_spacer_and_hollow_thigh" type="fixed">
        <origin xyz="-3.33067e-16 1.38778e-17 -0.0365" rpy="3.14159 -5.02899e-30 -1.5708" />
        <axis xyz="-0 -0 -1" />
        <parent link="spacer_between_thigh_connector_3" />
        <child link="thigh_connector_hollow_2" />
    </joint>
    <joint name="_frl__fastened_shaft_and_horseshoe" type="fixed">
        <origin xyz="-0.037 -0.00335 2.77556e-17" rpy="1.5708 2.34193e-30 -4.65921e-30" />
        <axis xyz="0 0 1" />
        <parent link="timing_belt_pulley_lower_shaft" />
        <child link="lower_shaft_connector_to_feet_3" />
    </joint>
    <joint name="_frl__fastened_shoulder_and_motor_1_casing" type="fixed">
        <origin xyz="0.17295 0.0045 -0.0065" rpy="-1.5708 -0 -1.5708" />
        <axis xyz="0 -1 0" />
        <parent link="shoulder_1" />
        <child link="motor_casing_1" />
    </joint>
    <joint name="_frl__fastened_shoulder_and_motor_2_casing" type="fixed">
        <origin xyz="0.0397 0.0045 -0.0065" rpy="-1.5708 -0 -1.5708" />
        <axis xyz="0 -1 0" />
        <parent link="shoulder_1" />
        <child link="motor_casing_2" />
    </joint>
    <joint name="_frl__fastened_spine_and_front_shoulder" type="fixed">
        <origin xyz="0.02625 0.212 -4.33681e-19" rpy="0 -0 0" />
        <axis xyz="0 0 1" />
        <parent link="torso" />
        <child link="shoulder_1" />
    </joint>
    <joint name="_frl__fastened_timing_belt_shaft_and_lower_pulley" type="fixed">
        <origin xyz="-2.32037e-14 7.82707e-15 0.01775" rpy="0 -1.5708 -0.323857" />
        <axis xyz="-1 -0 -0" />
        <parent link="timing_belt_pulley_lower_2" />
        <child link="timing_belt_pulley_lower_shaft" />
    </joint>
    <joint name="_frl__revolute_motor_1_and_thigh" type="continuous">
        <origin xyz="-0.0425 0.0337 5.55112e-17" rpy="0 -1.5708 -1.5708" />
        <axis xyz="0 0 -1" />
        <parent link="part_a_1__body1_6" />
        <child link="thigh_connecor_full_1" />
    </joint>
    <joint name="_frl__revolute_thigh_and_lower_pulley" type="continuous">
        <origin xyz="0.184559 0.000619719 1.52656e-15" rpy="-3.14159 -5.6e-17 -1.5708" />
        <axis xyz="0 0 -1" />
        <parent link="thigh_connector_hollow_2" />
        <child link="timing_belt_pulley_lower_2" />
    </joint>
    <joint name="brl__fastened_motor_5_casing_and_spacers" type="fixed">
        <origin xyz="-0.0223731 0.0451405 0.00325" rpy="-1.81493e-17 -2.24726e-17 3.14159" />
        <axis xyz="0 0 -1" />
        <parent link="motor_casing_5" />
        <child link="motor_casing_spacers_4" />
    </joint>
    <joint name="fastened_spine_and_back_shoulder" type="fixed">
        <origin xyz="0.02625 -0.176 -4.33681e-19" rpy="0 -0 0" />
        <axis xyz="0 0 1" />
        <parent link="torso" />
        <child link="shoulder" />
    </joint>
    <joint name="fastened_torso_and_battery" type="fixed">
        <origin xyz="-2.08167e-17 2.60209e-18 8.23994e-18" rpy="0 -1.5708 -6.83635e-17" />
        <axis xyz="1 -6.83635e-17 0" />
        <parent link="torso" />
        <child link="battery" />
    </joint>
    <joint name="fastened_torso_and_imu" type="fixed">
        <origin xyz="1.15094e-06 -0.000216697 0.0072" rpy="0 -0 0" />
        <axis xyz="0 0 -1" />
        <parent link="torso" />
        <child link="imu" />
    </joint>
    <joint name="fixed_node_to_root_joint" type="fixed">
        <origin xyz="0.000796373 0.000597279 -0.0036" rpy="0 -0 0" />
        <axis xyz="0 0 1" />
        <parent link="root" />
        <child link="torso" />
    </joint>
</robot>
