AfricanDaniel/metal-quadruped/dashboard/dashboard/likes.py

"""Persists "liked" models (2026-08-19, user request."""

import json
import os
import threading
import time

from dashboard.config import WS_ROOT

_LIKES_PATH = os.path.join(WS_ROOT, '.dashboard_likes.json')
_lock = threading.Lock()


def _key(host, folder, fname, basename):
    return f'{host}:{folder}:{fname}:{basename}'


def _load():
    if not os.path.exists(_LIKES_PATH):
        return {}
    try:
        with open(_LIKES_PATH) as f:
            return json.load(f)
    except (OSError, ValueError):
        return {}


def _save(data):
    # Atomic write (tmp + os.replace)
    tmp = _LIKES_PATH + '.tmp'
    with open(tmp, 'w') as f:
        json.dump(data, f, indent=2)
    os.replace(tmp, _LIKES_PATH)


def is_liked(host, folder, fname, basename):
    with _lock:
        return _key(host, folder, fname, basename) in _load()


def toggle_like(host, folder, fname, basename):
    """Returns the NEW liked state (bool)."""
    with _lock:
        data = _load()
        key = _key(host, folder, fname, basename)
        if key in data:
            del data[key]
            _save(data)
            return False
        data[key] = {
            'host': host, 'folder': folder, 'fname': fname, 'basename': basename,
            'liked_at': time.time(),
        }
        _save(data)
        return True


def list_likes():
    """[{host, folder, fname, basename, liked_at}], most recently liked first."""

    with _lock:
        data = _load()
    items = list(data.values())
    items.sort(key=lambda d: d.get('liked_at', 0), reverse=True)
    return items
