AfricanDaniel/metal-quadruped/(commit log)

2026-07-20 delte the data files
    [motor_0_20260716_193347.csv, motor_0_20260716_193627.csv, motor_0_20260716_193901.csv, motor_0_20260716_194101.csv, motor_0_20260716_194946.csv, motor_0_20260716_195159.csv, motor_0_20260716_195355.csv, motor_0_20260716_200107.csv]
2026-07-23 Added dog_description package to be tracked by git
    [IMU.stl, Part_A_1__Body1.stl, Part_B_1__Body1.stl, ball_for_feet.stl, battery.stl, dog.mjcf.xml, feet_connector.stl, full_dog.urdf]
2026-07-23 Updated actuator package to be tracked by git
2026-07-24 removed section that saves data to see motor data to a file
2026-07-24 Added a node to help calibrate the orientation of the imu WRT to the robot dog
    [imu_calibration.yaml]
2026-07-25 updated IMU files since robot is calibrated
    [imu_calibration.yaml]
2026-07-25 added a launch file + motor maping trial
    [motor_mapping_thigh_ac_corrected.yaml]
2026-07-25 updated model to havethe correct revoluto joint physics
    [dog.mjcf.xml]
2026-07-25 updated model to havethe correct revoluto joint physics+1
    [dog_env.py]
2026-07-25 Remove obsolete Onshape export files
    [Part_A_1__Body1.stl, Part_B_1__Body1.stl, ball_for_feet.stl, feet_connector.stl, full_dog.urdf, lower_shaft_connector_to_feet.stl, motor.stl, motor_casing.stl]
2026-07-26 updated files after first sim to real test
    [dog.mjcf.xml, motor_mapping_thigh_test.yaml]
2026-07-26 changed homing wrt 0
2026-07-27 updated calf symmentry const to fix sim
    [dog_env.py]
2026-07-27 Updated the thigh motors since they were moving in wrong direction
    [dog.mjcf.xml, motor_mapping.yaml, motor_mapping_thigh_test.yaml]
2026-07-27 fixed orientation for motor axis
    [dog.mjcf.xml, motor_mapping.yaml, motor_mapping_thigh_ac_corrected.yaml, motor_mapping_thigh_test.yaml]
2026-07-27 Increase Kp so motors push more agsins the floor
2026-07-27 fixed rviz joint limits
    [basic_control.cpp]
2026-07-27 fixed calf range for legs, not tested yet, leaving in a branch here
    [dog.mjcf.xml]
2026-07-27 added noise to sensors
    [dog_env.py]
2026-07-29 add walk height target fraction and PPO learning-rate flag
    - Dog-Walk-v0 now targets WALK_HEIGHT_FRACTION (0.75) of standing
    height instead of full STAND_HEIGHT_M -- a crouched target for a
    lower CoM and more stable gait, per request. Weight raised 0.2->0.6
    since the old "loose regularizer" strength wasn't enough to reliably
    hold a height target meant to provide real stability.
    - added --learning-rate to train.py (default 3e-4, unchanged behavior
    for existing runs). Matters most with --init-from: fine-tuning the
    penaltyFix stand checkpoint at the fresh-training default made
    raw-action jitter WORSE over 19M steps (74.7deg mean swing at 1M ->
    148.5deg at 20M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
    [dog_env.py]
2026-07-29 updated the training for walking, so that legs can swing and not drag
2026-07-29 updated penalty for standing, as dog gets higher, make the motors move less
2026-07-30 added landing velocity penalty such that the dog will walk softer and smoother
2026-07-30 added penalty for wobble when walking
    [dog_env.py]
2026-07-31 added penalaty for legs draggingn on grounf when moving
2026-08-02 added symetry between legs to help learn trot
2026-08-04 added knees to termination case
2026-08-04 first itteration of torque control
    [dog_torque.mjcf.xml]
2026-08-04 updated torque penalties
    [dog_torque_v1_legacy_5nm.xml]
2026-08-04 added fields needd to deplot torque policy on real robot
2026-08-05 added kd value for torque, added penalty to remove galloping from walking
2026-08-05 add control_mode=torque_belt (velocity-servo attempt, partial fix only)
    Adds an automatic, non-learned servo torque on the calf motors in torque
    mode, meant to replicate the real belt's free counter-rotation so the
    policy only has to learn genuine flexion. Verified directly: reduces
    absolute-calf drift from ~100% of thigh motion (plain torque, fully
    carried along) to ~39% at the best gain found, but does not fully hold
    the angle -- the servo saturates against the shared +-20 N*m ctrlrange
    (needed corrections regularly exceed 80-110 N*m) and shows oscillation
    at higher gains rather than converging. Root cause: this competes for the
    same limited torque budget as everything else on the actuator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
    [dog_env.py]
2026-08-05 add control_mode=torque_belt via MuJoCo fixed tendon (real fix)
    Replaces the abandoned control-layer velocity-servo (committed on
    torque_control_test) with a structural fix: generate_dog_mjcf.py
    --actuator-type torque_belt emits a <fixed> tendon per leg expressing
    the calf's ABSOLUTE (belt-decoupled) angle, and the calf <motor>
    actuator targets that tendon instead of its raw joint. MuJoCo's
    constraint solver distributes the resulting force back to the
    underlying joints exactly, so there's no competing-force/saturation
    problem the way the velocity-servo had.
    Verified directly against a fresh dog_torque_belt.mjcf.xml: a PD servo
    on the tendon's own state (ten_length/ten_velocity) holds within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
    [dog_torque_belt.mjcf.xml]
2026-08-05 added torque-belt
2026-08-05 added params to try fixing posiion walking
    [dog_env.py]
2026-08-06 WALKING WORKS CH1
    [dog.mjcf.xml]
2026-08-06 reverted the max clamp
    [dog_env.py]
2026-08-06 fixed spawn height for walking home
    [dog_env.py]
2026-08-06 add 3-tick observation history stack to DogEnv
    Gives the policy implicit visibility into recent state (qpos/qvel/
    sensordata/prev_action over the last 3 ticks) instead of a single
    snapshot, so it can infer how responsive the current episode's dynamics
    are -- needed now that position_kp/position_kd can be randomized
    per-episode (train.py's --position-kp-range-*), which otherwise makes
    the same action produce different real outcomes for reasons the network
    can't see.
2026-08-06 updated masses of the motors
    [dog.mjcf.xml]
2026-08-06 add adaptive KL-based learning rate schedule to train.py
    New --lr-schedule adaptive (opt-in, default stays 'linear'/unchanged)
    mirrors rsl_rl's PPO "adaptive" schedule (the same mechanism
    go2-sim2real-locomotion-rl's go2_train_walk.py uses): after each
    rollout's train() call, reads the actual KL divergence that update
    produced (SB3 already logs this) and shrinks the learning rate if the
    update moved the policy more than 2x --desired-kl, grows it if less
    than 0.5x. Meant to help both known problems in this project -- a fixed
    LR destabilizing an already-good policy on fine-tune, and a stalled
    policy getting no pressure to escape a local optimum (e.g. the
    "tumbling" walk gait) when updates are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
2026-08-07 WALKS AGAIN
    [dog_legacy_6kg.mjcf.xml]
2026-08-08 added termination condition that all 4 legs must be grouned to stand
2026-08-09 added penlaty for 3 legs only touching he floor
2026-08-09 added domain randomization to the offsets of the legs, since they are not perfetclt square
2026-08-10 added stand and walk policy, and walk staright correcttion
    [dog_env.py]
2026-08-10 added dr for more slippage and stand/walk
    [dog_env.py]
2026-08-11 added EMA filter
2026-08-12 first v after sag fix
    [dog_env.py]
2026-08-12 leg test
2026-08-14 added rewards in order to fix a leg oxer extending in sim when we pas in a low height
    [dog_env.py]
2026-08-14 last penalty fixes did not work, V2
    [dog_env.py]
2026-08-14 last penalty fixes did not work, V3
    [dog_env.py]
2026-08-14 last penalty fixes did not work, try on hfv8
    [dog_env.py]
2026-08-14 last penalty fixes did not work, try on hfv9
    [dog_env.py]
2026-08-14 last penalty fixes did not work, try on hfv10
    [dog_env.py]
2026-08-14 reverted back to 3legs working fine
    [basic_control.cpp, dog_env.py]
2026-08-15 first change after revert, v15 training
    [dog_env.py]
2026-08-15 added reward to halp feet clear ground
2026-08-15 added wondb board
2026-08-16 added a dashboard to replace all terminal usage
    [app.py, build_actions.py, config.py, download_actions.py, graphs.py, local_fs.py, policy_actions.py]
2026-08-16 Updated file to have new way to write to he motor, is fatser than orev calls
2026-08-16 updated max slew so that it decreases over time and havev less noise
    [dog_env.py]
2026-08-16 updated background to be more vizible in sim
    [dog.mjcf.xml, dog_legacy_6kg.mjcf.xml, dog_torque.mjcf.xml, dog_torque_belt.mjcf.xml, dog_torque_v1_legacy_5nm.xml]
2026-08-17 deleted torsional spring on the motors
    [dog.mjcf.xml, dog_legacy_6kg.mjcf.xml, dog_torque.mjcf.xml, dog_torque_belt.mjcf.xml, dog_torque_v1_legacy_5nm.xml]
2026-08-17 added sweep test for motors
2026-08-17 data sheep for belt coupling
2026-08-17 legs are swinging again
2026-08-17 added a belt coupling mecha just for demo purposes
2026-08-18 added home correction code for front feet
    [app.py, home_correction.py, policy_node.py, procs.py]
2026-08-18 rased foot clearance reward so back legs woruld clear more
    [app.py, dog_env.py, policy_actions.py]
2026-08-22 reverted back to v2 version?
    [app.py, config.py, dog_env.py, ros_actions.py, ssh.py]
2026-08-23 commitn - running_home_s5_ms1000_simple_alr_v1d — home start - running_stand_s5_ms1000_simple_alr_v1d — standing start
    was trained on
2026-08-24 cleanned up files V1
    [dog.mjcf.xml, dog_legacy_6kg.mjcf.xml, dog_torque.mjcf.xml, dog_torque_belt.mjcf.xml, dog_torque_v1_legacy_5nm.xml, motor_mapping.yaml]
2026-08-24 cleanned up commnents and docstrings
    [dog.mjcf.xml, dog_legacy_6kg.mjcf.xml, dog_torque.mjcf.xml, dog_torque_belt.mjcf.xml, dog_torque_v1_legacy_5nm.xml, imu_calibration.yaml]
2026-08-24 updated flowchart README
